wang-liusheng/Flight-control-board/README.md

参考匿名飞控原理图画的飞控板

没有ad库的可以在国产EDA上找库  立创eda怎么找库百度一下就明白了
