wang-liusheng/Flight-control-board/2021飞控板/飞控板说明.txt

2021-5-4：
能飞定高定点正常，但是只能提供两个5v外设。原因是因为板载负载能力不足。辅助电源的线太细了。
2021-6-1：
焊接功底很重要  不然板子可以用但是焊的不好也没有用  贴片的1k排阻容易虚焊。不要把12v的供电借口接到5v外设接口
2021-6-2
更改电源接口为sh1.0-6p为了是保护板子不被接错电源烧坏，增加subs硬件电路，
2021-7-4
tps5430的分压电阻不能焊接错误 焊接错误会导致电压过小或过大  可能导致mic5219异常发热和rgb异常发热

飞控板基本功能都可以用  出现了问题大多数原因都是因为元器件虚焊导致的  

一定要注意焊接技术和焊接方法

2021-7-14
rgb如果有一个颜色的灯一直点亮  可能是那个灯对应的mos管坏了

2021-7-16
如果swd没有用 在确定不是贴片排阻和sh1.0-4p的问题  那就是主控芯片焊接的有问题  注意每个引脚之间是不是有锡连在一起，把主控芯片重新检查焊接
