wang-liusheng/Flight-control-board/2021飞控板/1/飞控板说明.txt

2021-5-4：
能飞定高定点正常，但是只能提供两个5v外设。原因是因为板载负载能力不足。辅助电源的线太细了。
