wang-liusheng/Flight-control-board/(list of files, drawings)

Other design files:
2021飞控板/1/fkb.PrjPCB
2021飞控板/1/飞控板.PcbDoc
2021飞控板/1/飞控板.SchDoc
2021飞控板/2/飞控板2.PcbDoc
2021飞控板/2/飞控板2.PrjPCB
2021飞控板/2/飞控板2.SchDoc
2021飞控板/3/fkb.PrjPCB
2021飞控板/3/飞控板.PcbDoc
2021飞控板/3/飞控板.SchDoc
2021飞控板/4-四层板/fkb.PrjPCB
2021飞控板/4-四层板/飞控板.PcbDoc
2021飞控板/4-四层板/飞控板.SchDoc
